zilizii/MailBox_LP_Notifier/MailBox_LP_Notifier.kicad_pcb

## KiCad design MailBox_LP_Notifier.kicad_pcb (2024-06-27)

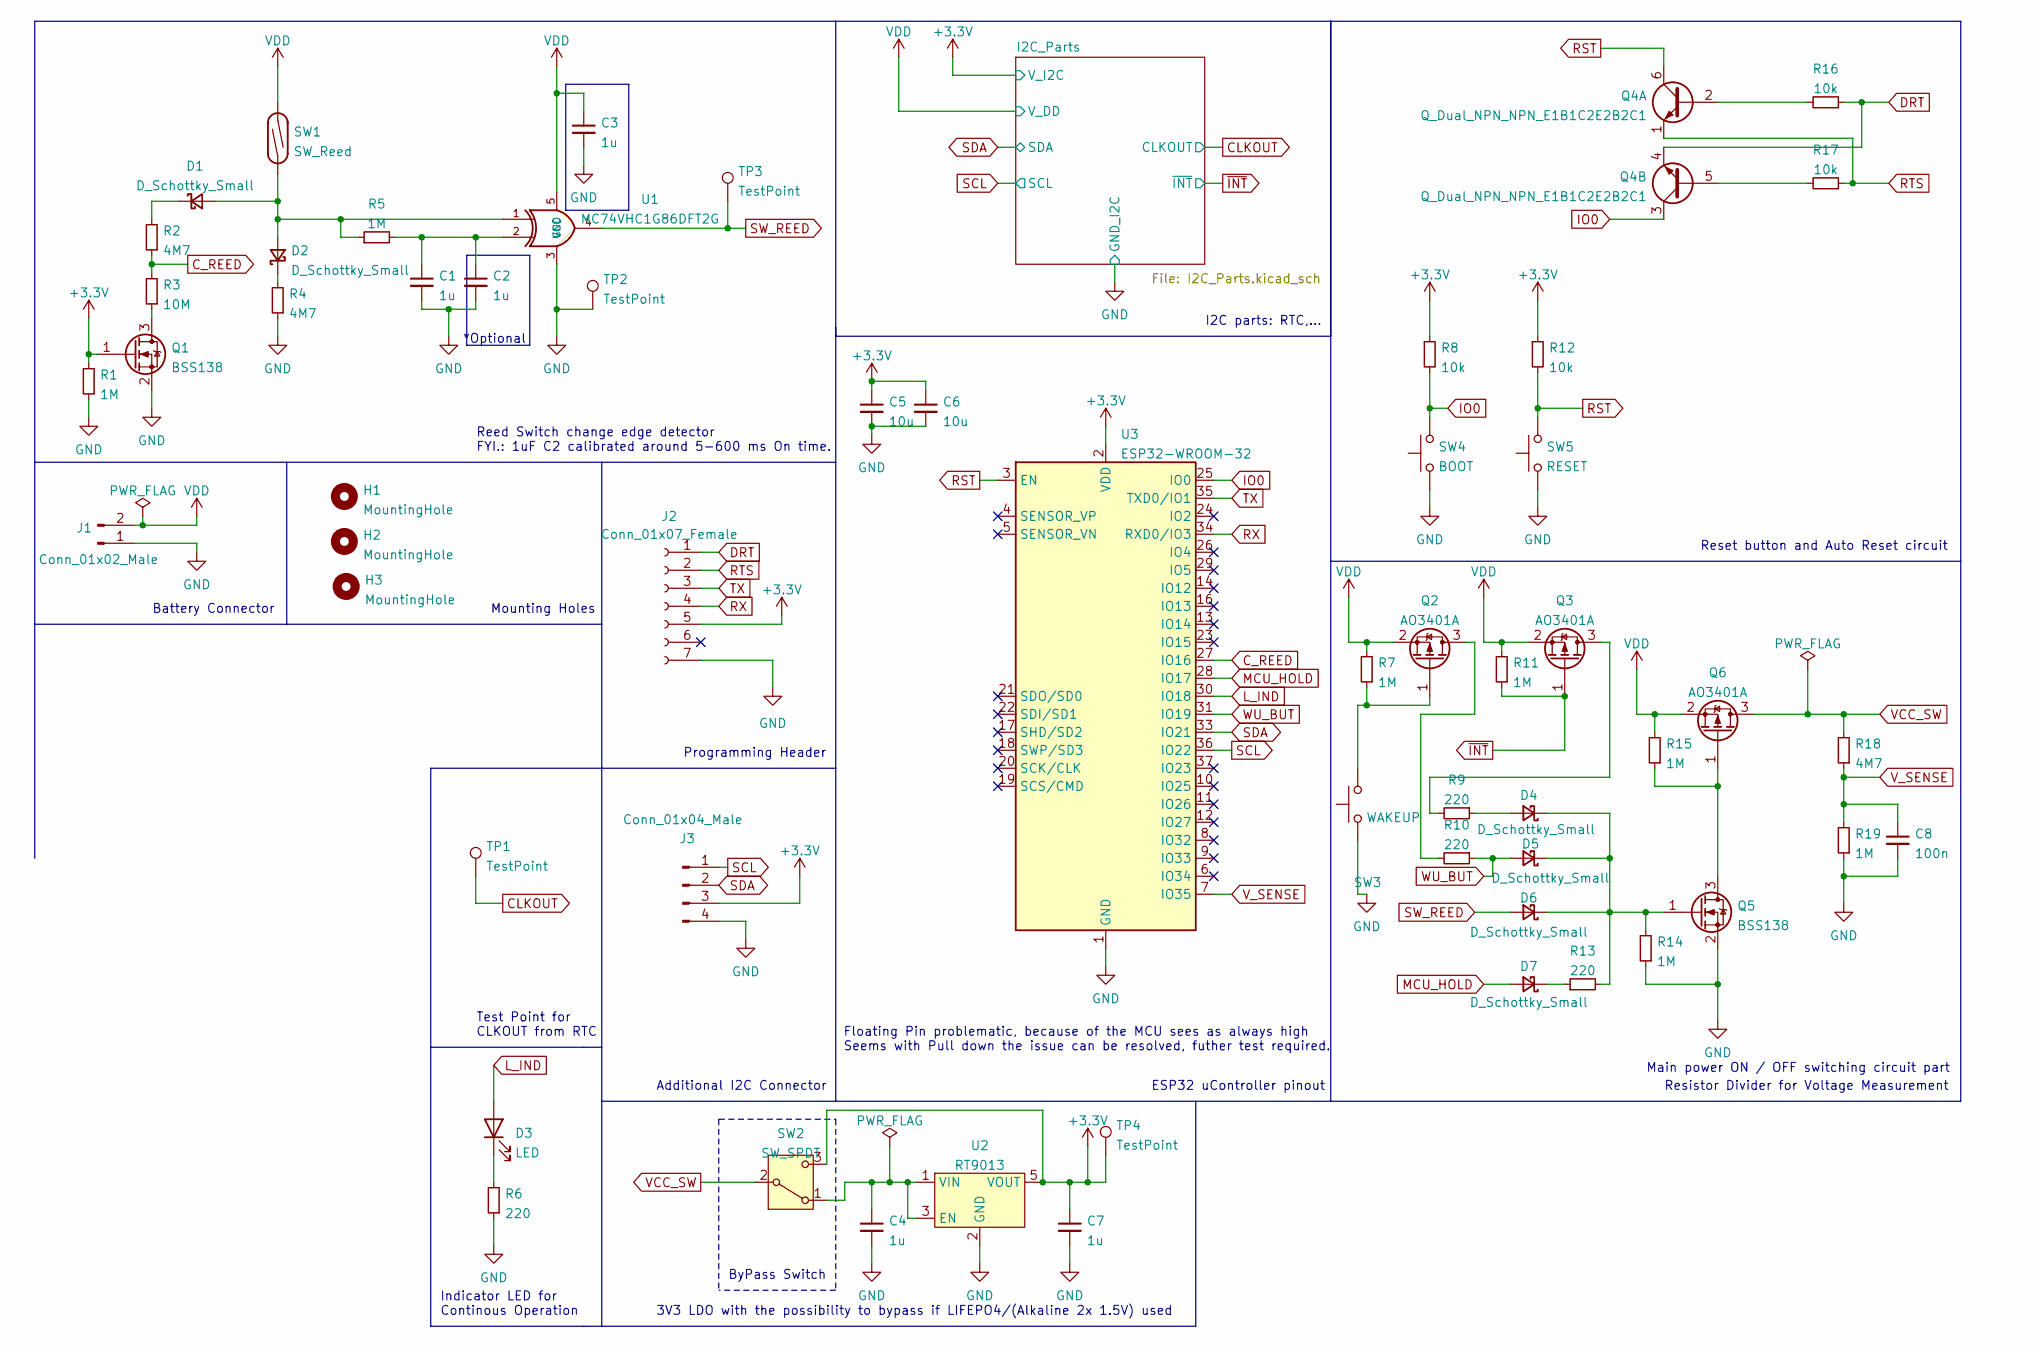
[picture p1: schematic MailBox_LP_Notifier.kicad_sch, Low Power Application for MailBox state checking]

Parts:
C1, C2, C3, C4, C7: 1u; C_0603_1608Metric
C5, C6: 10u; C_0603_1608Metric
C8: 100n; C_0603_1608Metric
D1, D2, D4, D5, D6, D7: D_Schottky_Small; D_SOD-123
D3: LED; LED_0805_2012Metric
H1, H2, H3: MountingHole; MountingHole_3.2mm_M3_DIN965
J1: Conn_01x02_Male; JST_PH_B2B-PH-K_1x02_P2.00mm_Vertical
J2: Conn_01x07_Female; PinSocket_1x07_P2.54mm_Vertical
J3: Conn_01x04_Male; JST_PH_S4B-PH-K_1x04_P2.00mm_Horizontal
Q1, Q5: BSS138; SOT-23
Q2, Q3, Q6: AO3401A; SOT-23
Q4: Q_Dual_NPN_NPN_E1B1C2E2B2C1; SOT-363_SC-70-6
R1, R5, R7, R11, R14, R15, R19: 1M; R_0603_1608Metric
R2, R4, R18: 4M7; R_0603_1608Metric
R3: 10M; R_0603_1608Metric
R6, R13: 220; R_0805_2012Metric
R8, R12, R16, R17: 10k; R_0603_1608Metric
R9, R10: 220; R_0603_1608Metric
SW1: SW_Reed; Molex_Micro-Fit_3.0_43045-0200_2x01_P3.00mm_Horizontal
SW2: SW_SPDT; SW_SPDT_PCM12
SW3: WAKEUP; SW_SPST_CK_RS282G05A3
SW4: BOOT; SW_SPST_CK_RS282G05A3
SW5: RESET; SW_SPST_CK_RS282G05A3
TP1, TP2, TP3, TP4: TestPoint; TestPoint_Pad_D1.0mm
U1: MC74VHC1G86DFT2G; SOT-23-5
U2: RT9013; SOT-23-5
U3: ESP32-WROOM-32

Connections:
+3.3V: C5.1, C6.1, C7.1, J2.5, J3.3, Q1.1 (G), R1.2, R8.1, R12.1, SW2.3 (C), TP4.1, U2.5 (VOUT), U3.2 (VDD); also elsewhere on the board
CLKOUT: TP1.1; also elsewhere on the board
C_REED: R2.1, R3.2, U3.27 (IO16)
DRT: J2.1, Q4.4 (E2), R16.1
GND: C1.2, C2.2, C3.2, C4.2, C5.2, C6.2, C7.2, C8.2, J1.1, J2.7, J3.4, Q1.2 (S), Q5.2 (S), R1.1, R4.1, R6.1, R14.1, R19.1, SW3.1, SW4.1, SW5.1, TP2.1, U1.3 (GND), U2.2 (GND), U3.1 (GND), U3.15 (GND), U3.38 (GND), U3.39 (GND); also elsewhere on the board
IO0: Q4.3 (C2), R8.2, SW4.2, U3.25 (IO0)
L_IND: D3.2 (A), U3.30 (IO18)
MCU_HOLD: D7.2 (A), U3.28 (IO17)
unnamed: C1.1, C2.1, R5.2, U1.2
unnamed: D1.2 (A), D2.2 (A), R5.1, SW1.1, U1.1
unnamed: D1.1 (K), R2.2
unnamed: D2.1 (K), R4.2
unnamed: D3.1 (K), R6.2
unnamed: D4.2 (A), R9.1
unnamed: D4.1 (K), D5.1 (K), D6.1 (K), Q5.1 (G), R13.2, R14.2
unnamed: D7.1 (K), R13.1
unnamed: Q1.3 (D), R3.1
unnamed: Q2.3 (D), R10.2
unnamed: Q2.1 (G), R7.1, SW3.2
unnamed: Q3.3 (D), R9.2
unnamed: Q4.2 (B1), R16.2
unnamed: Q4.5 (B2), R17.2
unnamed: Q5.3 (D), Q6.1 (G), R15.1
unnamed: C4.1, SW2.1 (A), U2.1 (VIN), U2.3 (EN)
RST: Q4.6 (C1), R12.2, SW5.2, U3.3 (EN)
RTS: J2.2, Q4.1 (E1), R17.1
RX: J2.4, U3.34 (RXD0/IO3)
SCL: J3.1, U3.36 (IO22); also elsewhere on the board
SDA: J3.2, U3.33 (IO21); also elsewhere on the board
SW_REED: D6.2 (A), TP3.1, U1.4
TX: J2.3, U3.35 (TXD0/IO1)
VCC_SW: Q6.3 (D), R18.2, SW2.2 (B)
VDD: C3.1, J1.2, Q2.2 (S), Q3.2 (S), Q6.2 (S), R7.2, R11.2, R15.2, SW1.2, U1.5 (VCC); also elsewhere on the board
V_SENSE: C8.1, R18.1, R19.2, U3.7 (IO35)
WU_BUT: D5.2 (A), R10.1, U3.31 (IO19)
~INT: Q3.1 (G), R11.1; also elsewhere on the board

Notes on the sheet:
Reset button and Auto Reset circuit
Mounting Holes
ESP32 uController pinout
ByPass Switch
Battery Connector
*Optional
I2C parts: RTC,...
Programming Header
Main power ON / OFF switching circuit part
Resistor Divider for Voltage Measurement
Test Point for CLKOUT from RTC
Indicator LED for Continous Operation
3V3 LDO with the possibility to bypass if LIFEPO4/(Alkaline 2x 1.5V) used
Reed Switch change edge detector FYI.: 1uF C2 calibrated around 5-600 ms On time.
Floating Pin problematic, because of the MCU sees as always high Seems with Pull down the issue can be resolved, futher test required.
Additional I2C Connector

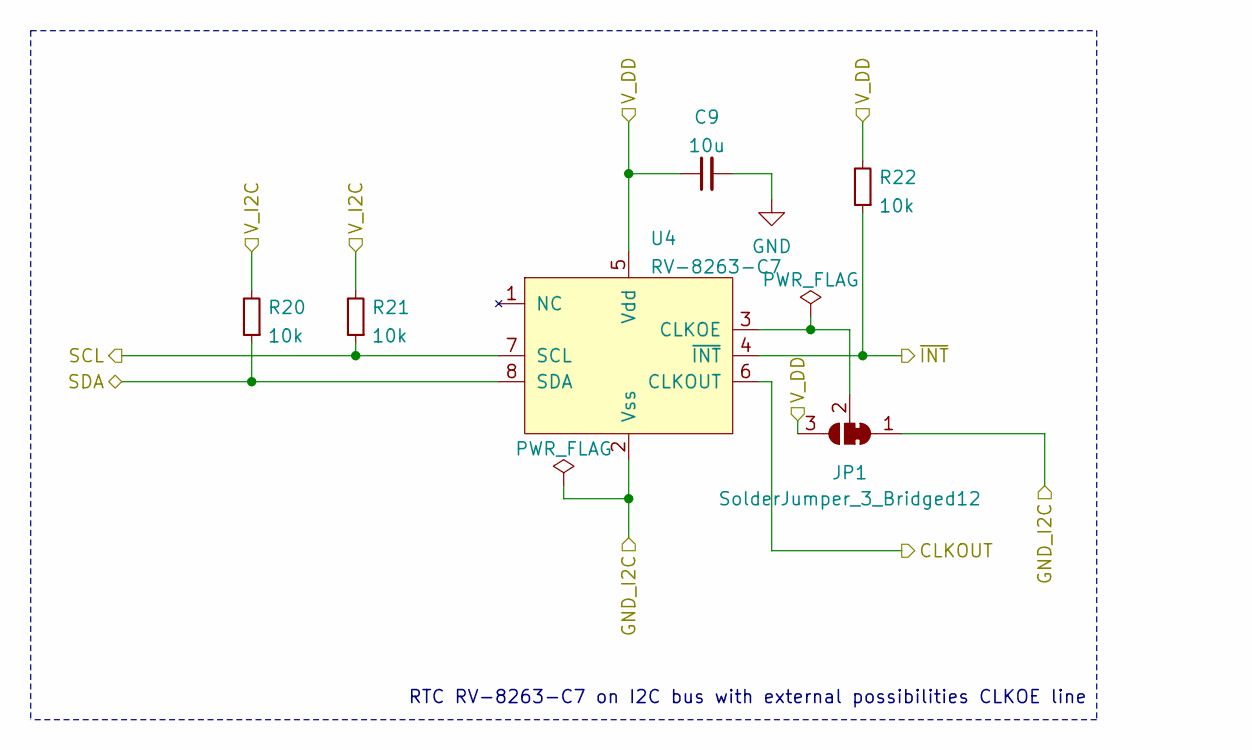
[picture p2: schematic I2C_Parts.kicad_sch]

Parts:
C9: 10u; C_0603_1608Metric
JP1: SolderJumper_3_Bridged12; SolderJumper-3_P1.3mm_Bridged2Bar12_RoundedPad1.0x1.5mm
R20, R21, R22: 10k; R_0603_1608Metric
U4: RV-8263-C7; C7

Connections:
+3.3V: R20.2, R21.2; also elsewhere on the board
CLKOUT: U4.6 (CLKOUT); also elsewhere on the board
GND: C9.2, JP1.1 (A), U4.2 (Vss); also elsewhere on the board
unnamed: JP1.2 (C), U4.3 (CLKOE)
SCL: R21.1, U4.7 (SCL); also elsewhere on the board
SDA: R20.1, U4.8 (SDA); also elsewhere on the board
VDD: C9.1, JP1.3 (B), R22.2, U4.5 (Vdd); also elsewhere on the board
~INT: R22.1, U4.4 (~INT); also elsewhere on the board

Notes on the sheet:
RTC RV-8263-C7 on I2C bus with external possibilities CLKOE line

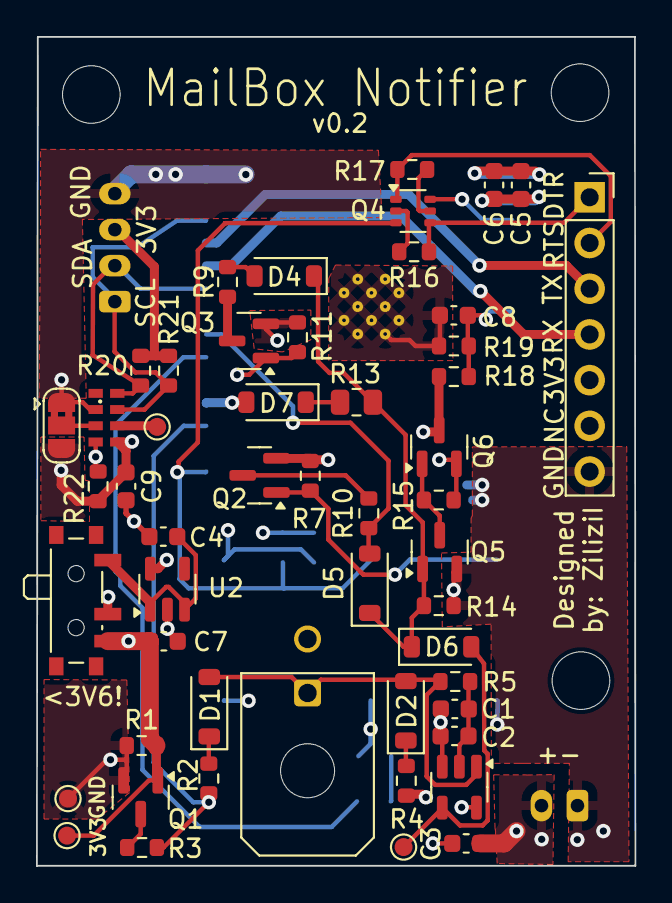
[picture p3: board MailBox_LP_Notifier.kicad_pcb from above]

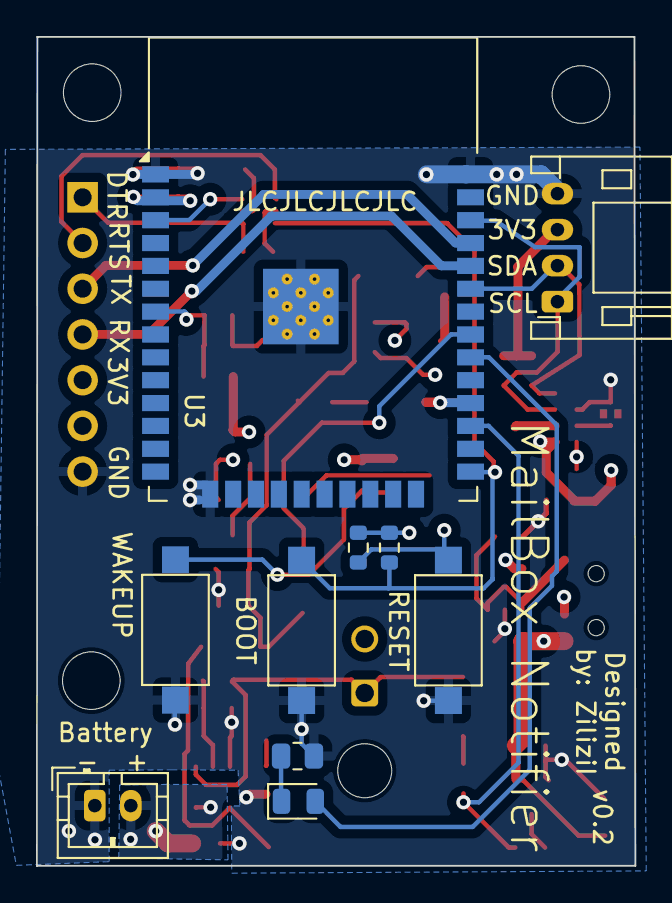
[picture p4: board MailBox_LP_Notifier.kicad_pcb from below]

Board: 4 copper layers, 33.2 x 46.1 mm, 64 parts (10 on the bottom side), 37 nets.
